megnergit/mecanum-buggy-esp32-e4/images/esp32-1.jpg

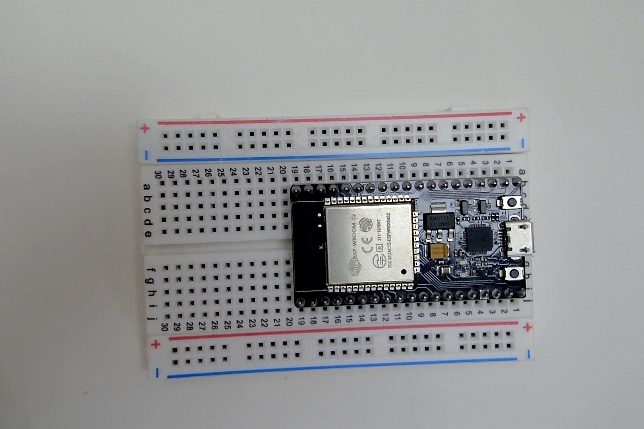
images/esp32-1.jpg
