megnergit/mecanum-buggy-esp32-e4/images/li-ion-battery-1.jpg

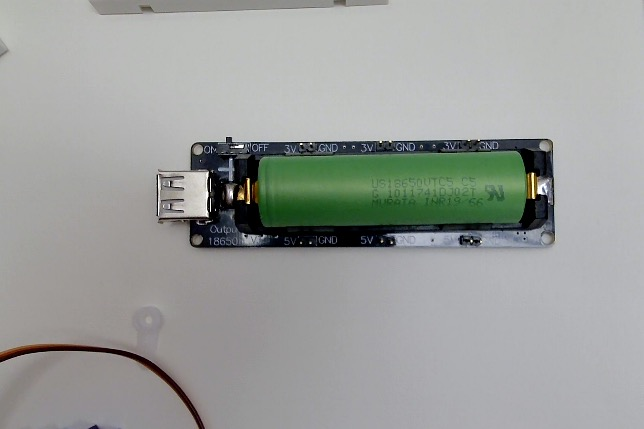
images/li-ion-battery-1.jpg
