megnergit/mecanum-buggy-esp32-e4/images/sg90-1.jpg

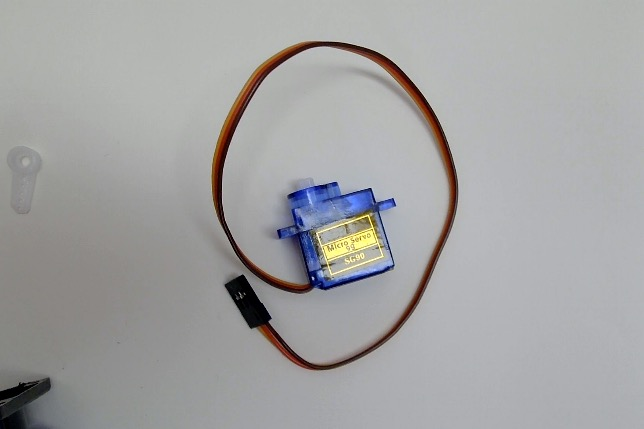
images/sg90-1.jpg
