megnergit/mecanum-buggy-esp32-e4/(commit log)

2025-11-13 Add pictures of chassis.
2025-11-13 Add all-wheel forward part.
